RegexCore/stm32-robot-arm-controller/STM32CubeMX/Configuration.ioc

Mcu.UserName=STM32F446RETx
PA0-WKUP.GPIO_Label=ADC1_IN0 Joystick left [VRY]
PA0-WKUP.Signal=ADCx_IN0
PA1.GPIO_Label=ADC1_IN1 Joystick left [VRX]
PA1.Signal=ADCx_IN1
PA13.GPIO_Label=TMS
PA13.Signal=SYS_JTMS-SWDIO
PA14.GPIO_Label=TCK
PA14.Signal=SYS_JTCK-SWCLK
PA15.GPIO_Label=GPIO_Input Button2 [SW]
PA15.Signal=GPIO_Input
PA2.GPIO_Label=USART_TX Bluetooth
PA2.Signal=USART2_TX
PA3.GPIO_Label=USART_RX Bluetooth
PA3.Signal=USART2_RX
PA4.GPIO_Label=ADC1_IN4 Joystick right [VRY]
PA4.Signal=ADCx_IN4
PA5.GPIO_Label=LD2 [Green Led]
PA5.Signal=GPIO_Output
PB0.GPIO_Label=ADC1_IN8 Joystick right [VRX]
PB0.Signal=ADCx_IN8
PB3.GPIO_Label=SWO
PB3.Signal=SYS_JTDO-SWO
PB8.GPIO_Label=I2C1_SCL PCA9685
PB8.Signal=I2C1_SCL
PB9.GPIO_Label=I2C1_SDA PCA9685
PB9.Signal=I2C1_SDA
PC10.GPIO_Label=GPIO_Input Joystick left [SW]
PC10.Signal=GPIO_Input
PC11.GPIO_Label=GPIO_Input Joystick right [SW]
PC11.Signal=GPIO_Input
PC12.GPIO_Label=GPIO_Input Button1 [SW]
PC12.Signal=GPIO_Input
PC13.GPIO_Label=B1 [Blue PushButton]
PC13.Signal=GPXTI13
PC14-OSC32_IN.Signal=RCC_OSC32_IN
PC15-OSC32_OUT.Signal=RCC_OSC32_OUT
PH0-OSC_IN.Signal=RCC_OSC_IN
PH1-OSC_OUT.Signal=RCC_OSC_OUT
