RegexCore/stm32-robot-arm-controller/(commit log)

2026-03-15 Translate comments to English and format code
    Convert German comments and documentation to English and apply code-style cleanups across the project. Changes touch config, controller, hardware (ADC, GPIO, I2C, timers, USART), and several headers/libraries — updating comments, log text, spacing, line-wrapping and minor non-functional formatting adjustments. No behavioral or algorithmic changes intended; mainly documentation and readability improvements.
2026-03-15 Update README hardware details and image
    Clarify and expand hardware component descriptions in the README (specify STM32F446RET6 as ARM Cortex-M4, identify PCA9685 as Adafruit 16-channel 12-bit PWM/Servo Shield with I2C, clarify USART2 as TX debug output, label HC-05 as Bluetooth serial module, and refine joystick and mode switch wording). Also replace the hardware-architecture.png diagram with an updated version.
2026-03-16 Add third_party component docs and licenses
    Add documentation and license files for third-party embedded support packages and update top-level README. Added ARM CMSIS Core and SEGGER README entries (third_party/arm_cmsis_core/README.md, third_party/segger/README.md), and added STMicroelectronics cmsis-device-f4 README and LICENSE (third_party/st_cmsis_device_f4/README.md, LICENSE.md). Update README.md to replace the previous copyright block with a Third-party components section pointing to third_party/ and advising to check individual file headers for license details.
2026-03-16 Improve third_party CMSIS README files
    Expand and clarify README files for third_party CMSIS components. For arm_cmsis_core: add a heading, clarify purpose, list the upstream repository, specify which CMSIS Core files are included (CMSIS_5/CMSIS/Core/Include/) and note that full license text appears in file headers. For st_cmsis_device_f4: rename "Upstream repository" to "Primary upstream repository" and add an additional distribution source (STM32CubeF4). Licensing remains Apache 2.0.
2026-03-16 Add copyright notice to README
    Insert a Copyright section into README.md declaring "Copyright (c) 2026 Manuel Wiesinger". This is a documentation-only change placed above the Third-party components section; no functional code changes.
2026-03-16 Adopt MIT license and add SPDX headers
    Replace the proprietary license with the MIT License (update LICENSE) and update README to reference the License section. Add SPDX-License-Identifier: MIT headers to multiple source and header files and remove the previous "All rights reserved." proprietary notice and redundant author/created lines in file headers. These changes make project licensing explicit and improve compatibility with tooling that recognizes SPDX identifiers.
    [hw_adc.c, hw_adc.h, hw_gpio.c, hw_gpio.h, hw_i2c.c, hw_i2c.h, hw_usart.c, hw_usart.h]
2026-03-16 Clarify microcontroller platform in README
    Update README to specify the development board and correct MCU identifier: replace 'Microcontroller: STM32F446RET6' with 'Microcontroller platform: ST Nucleo-F446RE (STM32F446RE, ARM Cortex-M4)' to make the target hardware clearer.
2026-03-17 Set SysTick IRQ priority to 15
    Call NVIC_SetPriority(SysTick_IRQn, 15) in systick_init (hardware/timer/systicktimer.c) before initializing systick_time_ms. This ensures the SysTick interrupt runs at the configured low priority and doesn't preempt higher-priority handlers.
    [systicktimer.c]
2026-03-17 Mark tiny_delay asm as volatile
    Change inline assembly in tiny_delay from __asm__("nop") to __asm__ volatile ("nop") so the compiler cannot optimize away the busy-wait loop. Added a brief comment explaining the reason for volatile.
2026-03-17 Remove redundant comment before SysTick printf
    Remove an unnecessary comment in hardware/timer/systicktimer.c that preceded the printf logging the SystemCoreClock. No functional changes; minor code cleanup to reduce clutter.
2026-03-17 Refine hardware components section in README
    Improve and standardize the hardware components list: clarify the microcontroller board name, add a Robot Manipulator Platform entry (Joy-IT multi-axis robotic arm), rename and clarify the PCA9685 PWM driver as an external controller board, specify the HC-05 as a UART-connected Bluetooth transceiver, and rephrase joystick and digital input descriptions for clarity.
2026-03-17 Use tenths for MHz display
    Rename 'centi' to 'deci' and adjust the divisor from 10000 to 100000 so the SystemCoreClock printout shows MHz with one decimal (tenths) instead of two. Update the Logger::printf call in main.cpp to use the new variable.
2026-03-19 Add robotic arm user manual
    Introduce a comprehensive user manual (docs/user-manual.md) for the robotic arm covering system startup and referencing, axis overviews (A1–A6/G6) with activation details, manual and automatic operating modes, emergency stop procedures, and safety notes. The document includes referenced images and guidance for joystick/gripper controls to support safe production use and operator training.
2026-03-19 Add documentation images for robot UI and axes
    Add multiple PNG assets to docs/images to support the documentation: automatic_mode, manual_mode, axis1_base_rotation, axis2_shoulder, axis3_elbow, axis4_tilt, axis5_wrist_rotation, gripper_control, emergency_stop, and referencing. These images illustrate UI modes, control elements, and joint axes to improve hardware and user guidance in the docs.
2026-03-19 Update user manual content and layout
    Rewrite and reformat the user manual: simplify wording, convert verbose lists to concise bullets, and standardize figure captions. Add an Image Attribution section for the “Joystick KY-023” model (CC-BY-SA) and point to the main README for full details. Clarify referencing/startup procedure with a warning not to interfere, reorganize and streamline Axis 1–6 descriptions and images, and consolidate wrist/gripper activation instructions. Update Manual and Automatic mode wording (disable joystick input during automatic mode) and refine Emergency Stop and Safety Instructions (renamed from Safety Notes) with clearer restart/inspection steps and an added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
2026-03-19 Use descriptive image names in user manual
    Update image references in docs/user-manual.md to more descriptive filenames (axis1_base_rotation, axis2_shoulder, axis3_elbow, axis4_tilt, axis5_wrist_rotation, gripper_control). Improves clarity and consistency of image assets; no other content changes.
2026-03-19 Increase docs image heights and update first alt
    Increase the displayed height of multiple figure images in docs/user-manual.md from 400 to 700 to improve readability. Also update the first figure's alt text and caption to better describe the robotic arm axis configuration and designation. Changes affect several axis and mode illustration entries throughout the manual.
2026-03-19 Add section separator to user manual
    Insert a Markdown horizontal rule between the 'The system is ready for operation...' paragraph and the following HTML div in docs/user-manual.md to improve visual separation and readability of the documentation.
2026-03-19 Set image width to 630 in user manual
    Replace height="700" with width="630" for multiple figure images in docs/user-manual.md to standardize image sizing and improve layout consistency (axis1, axis2, axis3, axis4, axis5, gripper_control, manual_mode, automatic_mode, emergency_stop). No functional changes.
2026-03-20 Add motor assignment section to user manual
    Document motor-to-axis mapping for the robotic arm by adding a new "Motor Assignment" section with a table listing Motor 0–Motor 5 and their corresponding axes/functions (A1–A5 and G6). Clarifies numbering (Motor 0..5), explains that A1–A5 control spatial movement and G6 controls the gripper, and provides brief descriptions for each motor. Also includes minor formatting cleanups around figure blocks.
2026-03-20 Document PCA9685 servo shield and channel map
    Update README to replace the generic PCA9685 reference with a detailed section on the Adafruit PCA9685 16-channel PWM/Servo Shield. Adds hardware characteristics (I2C control, 12-bit PWM, freq info, stackable, voltage compatibility), wiring notes (external servo supply, common ground), and a servo-to-PCA9685 channel assignment table for motors 0–5. Clarifies that remaining channels are unused and may be reserved for future extensions.
2026-03-20 Add User Documentation section to README
    Add a new "User Documentation" section to README linking to docs/user-manual.md. The section points users to detailed operating instructions for the robotic arm (axis control, joystick functions, and automatic motion sequences) and is inserted above the Analog Input Channels section for easier discoverability.
2026-03-21 Document kinematic model limitations
    Add a new README section describing the current kinematic model limitations: the model uses two segments (L1 upper arm, L2 forearm), assumes the tool center point coincides with the wrist axis, and does not account for gripper/tool offsets. Explain this simplification was intentional to reduce complexity and aid initial testing on the embedded target, and note that the architecture supports future extension (e.g., adding a tool center point offset). Also update the potential future extensions list to mention introducing a TCP offset for accurate Cartesian positioning.
2026-03-21 Add kinematics overview image and calibration docs
    Add an illustrative kinematic overview image (docs/images/robot-arm-kinematics-overview.png) and update README.md with the figure and explanatory text. Introduces a new "Kinematic Reference Alignment (Servo Offset Calibration)" section that describes the zero-position convention, a per-joint servo offset calibration procedure, and the runtime compensation behavior. Also adds minor formatting and wording improvements around tool-center-point offsets, inversion settings, and the rationale for separating installation-dependent corrections from the pure kinematic model.
2026-03-21 Update robot arm kinematics overview image
    Replace docs/images/robot-arm-kinematics-overview.png with an updated binary image asset. No source code changes; the diagram/image file has been refreshed.
2026-03-22 Add security policy (SECURITY.md)
    Add SECURITY.md with the project's security policy. It outlines the purpose for an educational robotic arm firmware, how to report vulnerabilities (including required reproduction and impact details), the scope of security considerations (e.g., unintended servo movement, communication weaknesses, emergency stop handling), a disclaimer about non-production use, and a note that no long-term security support is provided.
2026-03-22 Rename Author to Project Information
    Update README: change the table-of-contents entry from 'Author' to 'Project Information' and replace the ## Author section with ## Project Information. Add project metadata: Author: Manuel Wiesinger, Development period: February – March 2026, and Status: Functional prototype.
2026-03-23 Clarify README: specify 6-DOF arm with gripper
    Update README to explicitly describe the project as a 6-DOF robotic arm with gripper (bolded in the intro). This makes hardware and capability expectations clearer for contributors and users.
2026-03-23 Add control panel IDC ribbon cable to README
    Document the control panel interconnection cable in the hardware components list: a 40-pin IDC ribbon cable extension (approx. 10 cm) used to connect the custom joystick control panel PCB with the STM32 control electronics.
2026-03-23 Add STM32CubeMX pinout and README section
    Add a new STM32 Pin Configuration section to the README and include the corresponding pinout image (docs/images/stm32-cubemx-pinout.png). The section documents ADC, GPIO, USART debug and I2C (PCA9685) mappings used by the firmware on the Nucleo-F446RE and notes that the STM32CubeMX project (.ioc) is included in the repository.
2026-03-23 Reorder and expand README hardware section
    Move and consolidate the hardware components list earlier in the README, expand it into a clear bullet list (MCU, manipulator, PCA9685, HC-05, joystick panel, E-stop/switches, IDC cable). Add a "STM32F446 Pin Configuration" heading and reword the accompanying paragraph to clarify the STM32CubeMX pinout and peripheral mappings; remove the duplicated hardware list further down the file.
2026-03-23 Move User Documentation section and update TOC
    Reorganized README by removing the earlier User Documentation block and reintroducing it later in the file to improve document flow. Also added a corresponding entry to the table of contents so the manual link (docs/user-manual.md) is discoverable from the TOC.
2026-05-08 Add Design Principles section to README, outlining low coupling and high cohesion
2026-10-02 feat: Implement remote Cartesian target commands via HC-05
    - Added support for remote target commands in manual mode, allowing the robotic arm to accept commands via HC-05.
    - Introduced a new protocol for motion commands, including parsing for optional parameters (tilt, rotation, gripper).
    - Enhanced the RobotController to handle motion command queuing and execution.
    - Updated user manual to document the new remote command features and usage instructions.
    - Refactored USART2 driver to support interrupt-driven reception and motion permission handling.
    - Improved servo control logic to ensure smooth operation during remote commands and emergency stop conditions.
2026-10-02 feat: Add MCP server configuration for STM32 robot
